e-abdi/UVP6-Seaglider/mechanical/Brackets.step

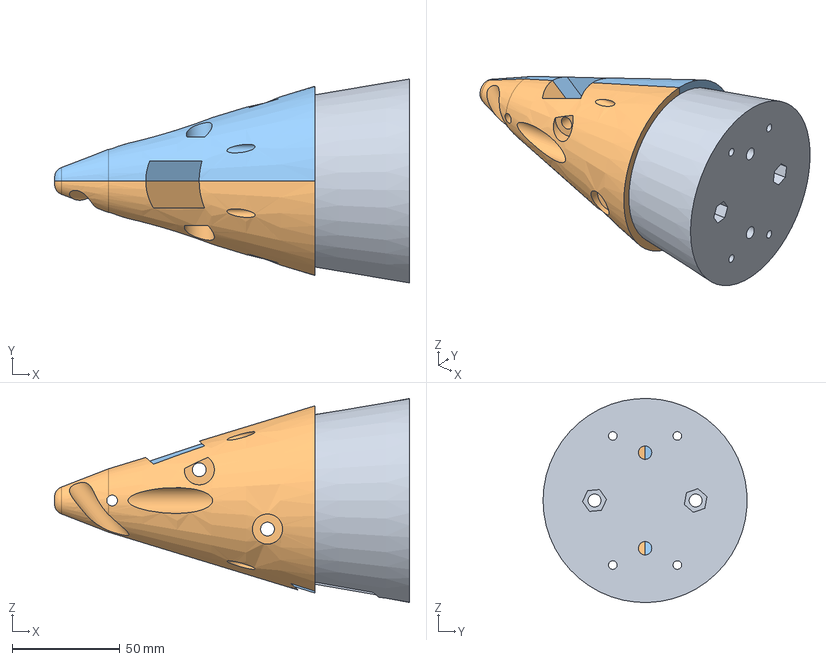
[picture p11: CAD file, 2026-10-20]
mechanical/Brackets.step
165.0 x 94.8 x 94.8 mm
