e-abdi/UVP6-Seaglider/mechanical/Shell Parts.step

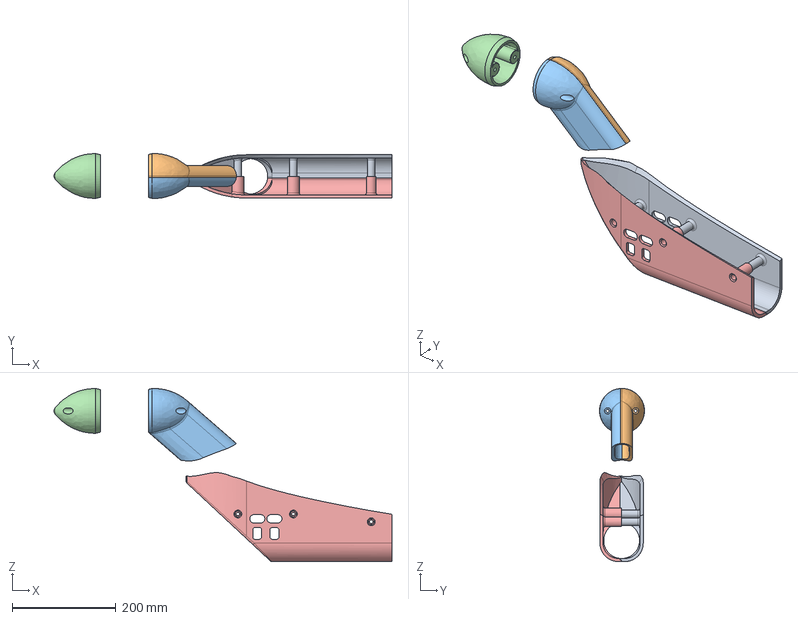
[picture p12: CAD file, 2026-10-20]
mechanical/Shell Parts.step
651.5 x 86.7 x 333.8 mm
