e-abdi/UVP6-Seaglider/(commit log)

2026-10-20 Update main photo, add CAD files, and trim README
    Replace the main photo, drop "Mechanical" from the title, link the
    bracket and shell STEP files, and remove the Future improvements section.
    [Brackets.step, Shell Parts.step]
2026-10-20 Move CAD files to mechanical directory
    [Brackets.step, Shell Parts.step]
